juamunleo/ble_device_tfg/KiCad_PCB/BOM.xlsx

BOM
NO | Designator | Quantity | Part Number | Description | Value | Package | Comment or Link
1 | R1 | 1 |  | 200Ohms resistor | 200 | 0603
2 | R2 | 1 |  | 1kOhms resistor | 1k | 0603
3 | BT1 | 1 | BAT-HLD-001-THM-TR | Battery Holder |  |  | https://www.mouser.es/ProductDetail/Linx-Technologies/BAT-HLD-001-THM-TR?qs=1sbE9T7hb3a7mD8p42MgHg%3D%3D
4 | C2,C3,C4,C5 | 4 |  | 12pF capacitor | 12p | 0603
5 | C7, C11, C12 | 3 |  | 0.1 uF(100nF) capacitor | 0.1u | 0603
6 | C8 | 1 |  | 1uF capacitor | 1u | 0603
7 | C19 | 1 |  | 100pF capacitor | 100p | 0603
8 | C10 | 1 |  | 0.8pF capacitor | 0.8p | 0603
9 | C13 | 1 |  | 4.7uF capacitor | 4.7u | 0603
10 | D1 | 1 | 597-3111-407F | LED |  |  | https://www.mouser.es/ProductDetail/Dialight/597-3111-407F?qs=DVhSRDYZfLqO0KXLkTIRsA%3D%3D
11 | E1 | 1 | 2450AT18B100E | Bluetooth 2.45GHz Antenna |  |  | https://www.mouser.es/ProductDetail/Johanson-Technology/2450AT18B100E?qs=yCnrNFeXz%252Bh5MFsFIXGZGA%3D%3D
12 | J1 | 1 | 53048-0450 | Headers & Wire Housings |  |  | https://www.mouser.es/ProductDetail/Molex/53048-0450?qs=0lSvoLzn4L%252Bhzo05ywM78Q%3D%3D
13 | L1 | 1 | CV201210-100K | 10uH inductor | 10u |  | https://www.mouser.es/ProductDetail/Bourns/CV201210-100K?qs=k2%252BVLg4AuuRLt64STpwovw%3D%3D
14 | L2 | 1 | CE201210-3N9J | 3.9nH inductor | 3.9n |  | https://www.mouser.es/ProductDetail/Bourns/CE201210-3N9J?qs=BtXXpjEiAfEUCJPU6Gr3oA%3D%3D
15 | L3 | 1 | CE201210-15NJ | 15nH inductor | 15n |  | https://www.mouser.es/ProductDetail/Bourns/CE201210-15NJ?qs=8tpky8Qe03JgTaGyIOKDlQ%3D%3D
16 | S1 | 1 | FSMCTTR | Switch |  |  | https://www.mouser.es/ProductDetail/TE-Connectivity-Alcoswitch/FSMCTTR?qs=Of7OaoM7rsGuzG65URnwLw%3D%3D
17 | U2 | 1 | nRF52832-QFAA-R | nrf52832 SoC |  |  | https://www.mouser.es/ProductDetail/Nordic-Semiconductor/nRF52832-QFAA-R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
18 | Y1 | 1 | ECS-320-8-33B-7KM-TR | Crystals 32MHz 8pF 40 ohms -20C to 70C | 32MHz |  | https://www.mouser.es/ProductDetail/ECS/ECS-320-8-33B-7KM-TR?qs=B6kkDfuK7%2FCuFLoe%2FuNdsQ%3D%3D
19 | Y2 | 1 | ECS-.327-12.5-12R-TR | Crystals 32.768kHz 12.5pF -40C +85C | 32.768KHz |  | https://www.mouser.es/ProductDetail/ECS/ECS-327-125-12R-TR?qs=fAHHVMwC%252BbjIsh0rr7Av6w%3D%3D
