juamunleo/ble_device_tfg/KiCad_PCB/simbolos_huellas_externos/2450AT18B100E/2450AT18B100E.step

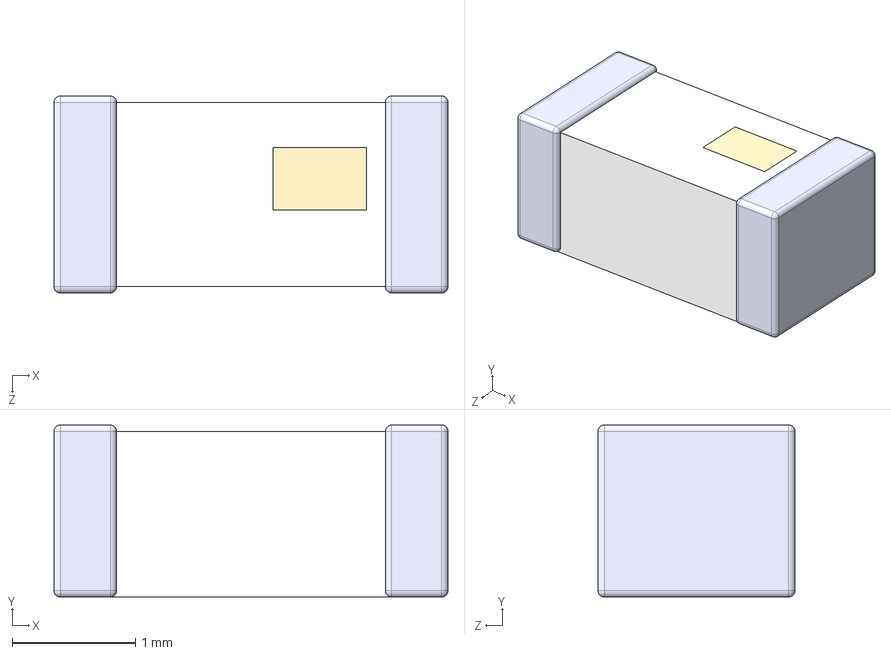
[picture p1: CAD file, 2022-02-11]
KiCad_PCB/simbolos_huellas_externos/2450AT18B100E/2450AT18B100E.step
3.20 x 1.40 x 1.60 mm
