juamunleo/ble_device_tfg/KiCad_PCB/simbolos_huellas_externos/597-3111-407F/597-3111-407F.step

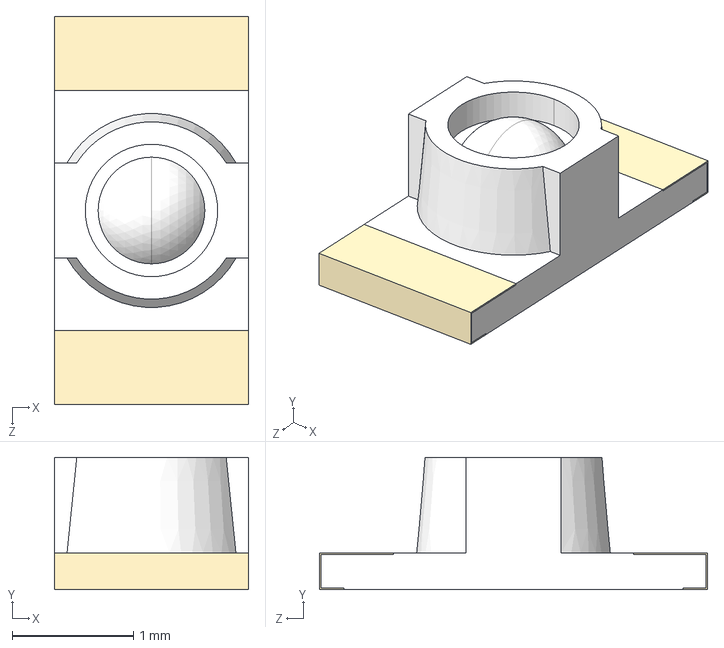
[picture p2: CAD file, 2022-02-11]
KiCad_PCB/simbolos_huellas_externos/597-3111-407F/597-3111-407F.step
1.60 x 1.09 x 3.20 mm
