juamunleo/ble_device_tfg/KiCad_PCB/simbolos_huellas_externos/8-1437565-0/8-1437565-0.step

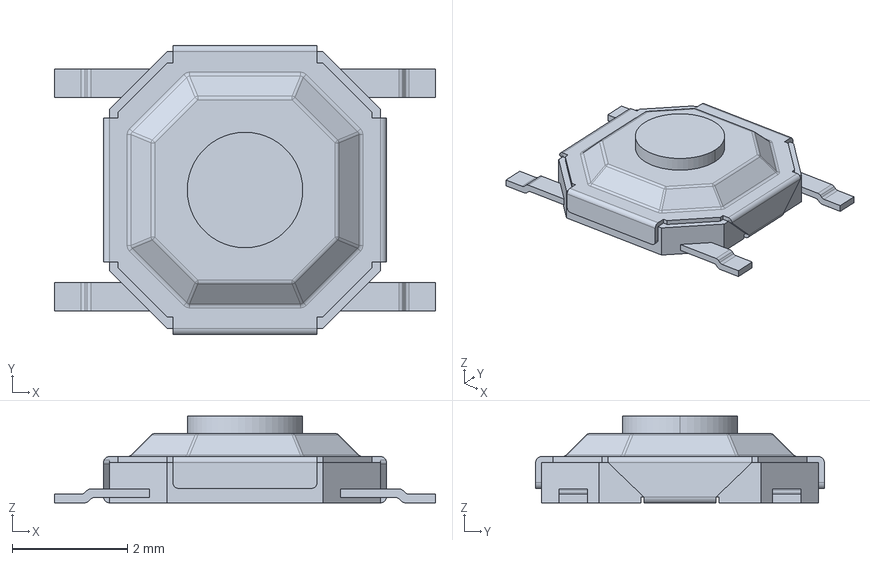
[picture p3: CAD file, 2022-02-11]
KiCad_PCB/simbolos_huellas_externos/8-1437565-0/8-1437565-0.step
6.60 x 5.00 x 1.50 mm
