juamunleo/ble_device_tfg/KiCad_PCB/simbolos_huellas_externos/B3U-3000P/B3U-3000P.step

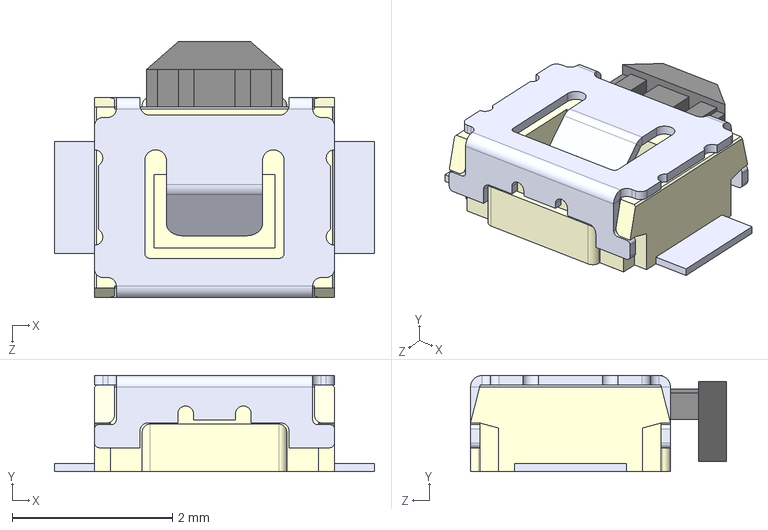
[picture p4: CAD file, 2022-02-11]
KiCad_PCB/simbolos_huellas_externos/B3U-3000P/B3U-3000P.step
4.00 x 1.20 x 3.20 mm
