juamunleo/ble_device_tfg/KiCad_PCB/simbolos_huellas_externos/BAT-HLD-001-THM-TR/BAT-HLD-001-THM-TR.step

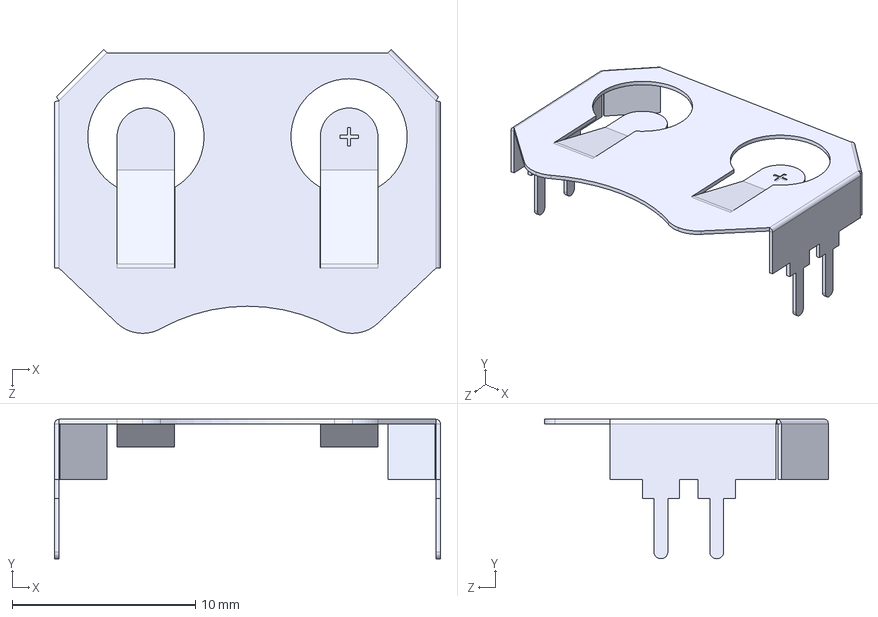
[picture p5: CAD file, 2022-03-05]
KiCad_PCB/simbolos_huellas_externos/BAT-HLD-001-THM-TR/BAT-HLD-001-THM-TR.step
21.1 x 7.62 x 15.5 mm
