juamunleo/ble_device_tfg/KiCad_PCB/simbolos_huellas_externos/ECS-.327-12.5-12R-TR/ECS-.327-12.5-12R-TR.step

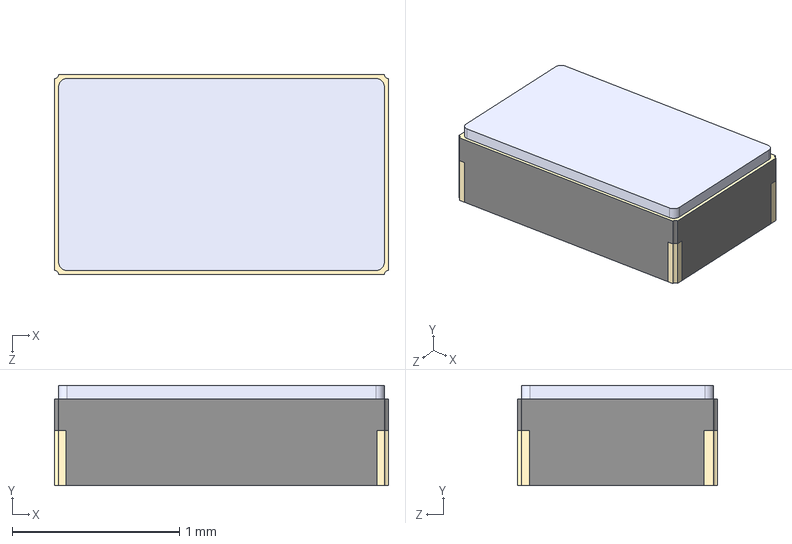
[picture p6: CAD file, 2022-02-11]
KiCad_PCB/simbolos_huellas_externos/ECS-.327-12.5-12R-TR/ECS-.327-12.5-12R-TR.step
2.00 x 0.6 x 1.20 mm
