juamunleo/ble_device_tfg/KiCad_PCB/simbolos_huellas_externos/LT3021ES8/LT3021ES8.step

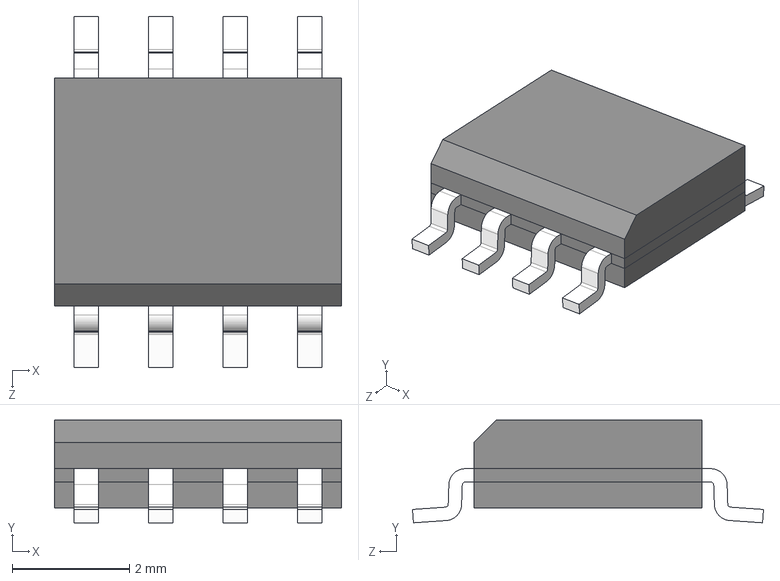
[picture p7: CAD file, 2022-02-10]
KiCad_PCB/simbolos_huellas_externos/LT3021ES8/LT3021ES8.step
4.90 x 1.75 x 5.99 mm
