juamunleo/ble_device_tfg/KiCad_PCB/simbolos_huellas_externos/USB-C31-S-RA-CS2-SMT-BK-T R/USB-C31-S-RA-CS2-SMT-BK-T_R.step

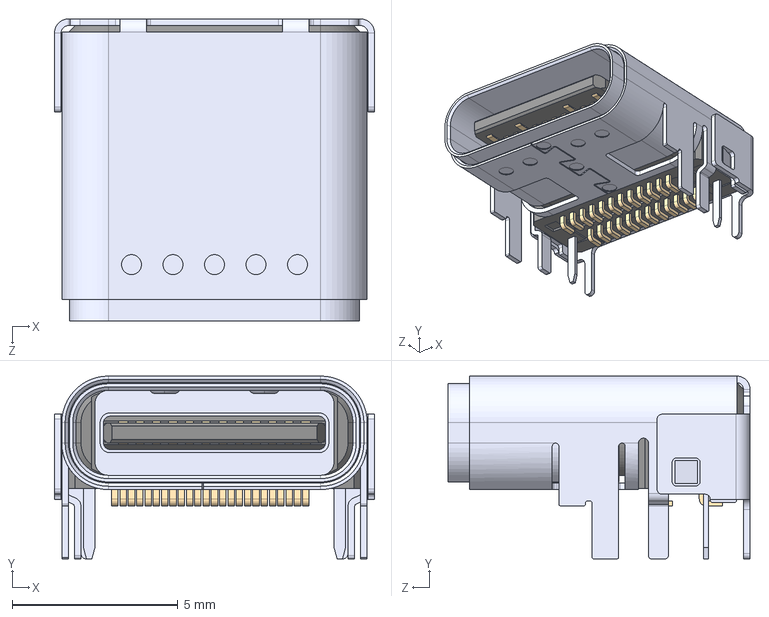
[picture p8: CAD file, 2022-02-10]
KiCad_PCB/simbolos_huellas_externos/USB-C31-S-RA-CS2-SMT-BK-T R/USB-C31-S-RA-CS2-SMT-BK-T_R.step
9.64 x 5.51 x 9.10 mm
