juamunleo/ble_device_tfg/KiCad_PCB/simbolos_huellas_externos/530480450/530480450.stp

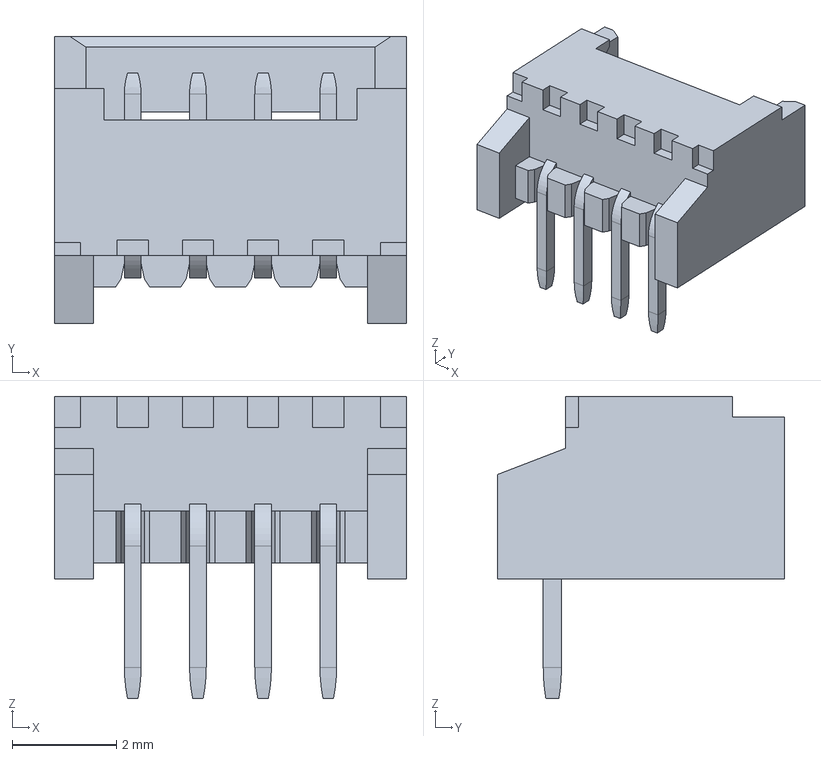
[picture p9: CAD file, 2022-03-05]
KiCad_PCB/simbolos_huellas_externos/530480450/530480450.stp
6.75 x 5.50 x 5.80 mm
