juamunleo/ble_device_tfg/KiCad_PCB/simbolos_huellas_externos/NRF52832-QFAA-R/NRF52832-QFAA-R.step

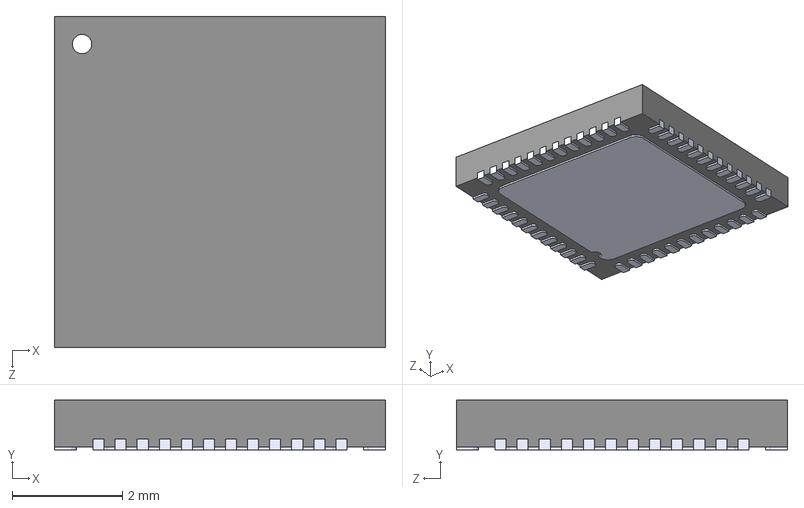
[picture p10: CAD file, 2022-02-10]
KiCad_PCB/simbolos_huellas_externos/NRF52832-QFAA-R/NRF52832-QFAA-R.step
6.00 x 0.9 x 6.00 mm
