juamunleo/ble_device_tfg/KiCad_PCB/KiCad_PCB.kicad_pcb

## KiCad design KiCad_PCB/KiCad_PCB.kicad_pcb (2022-03-21)

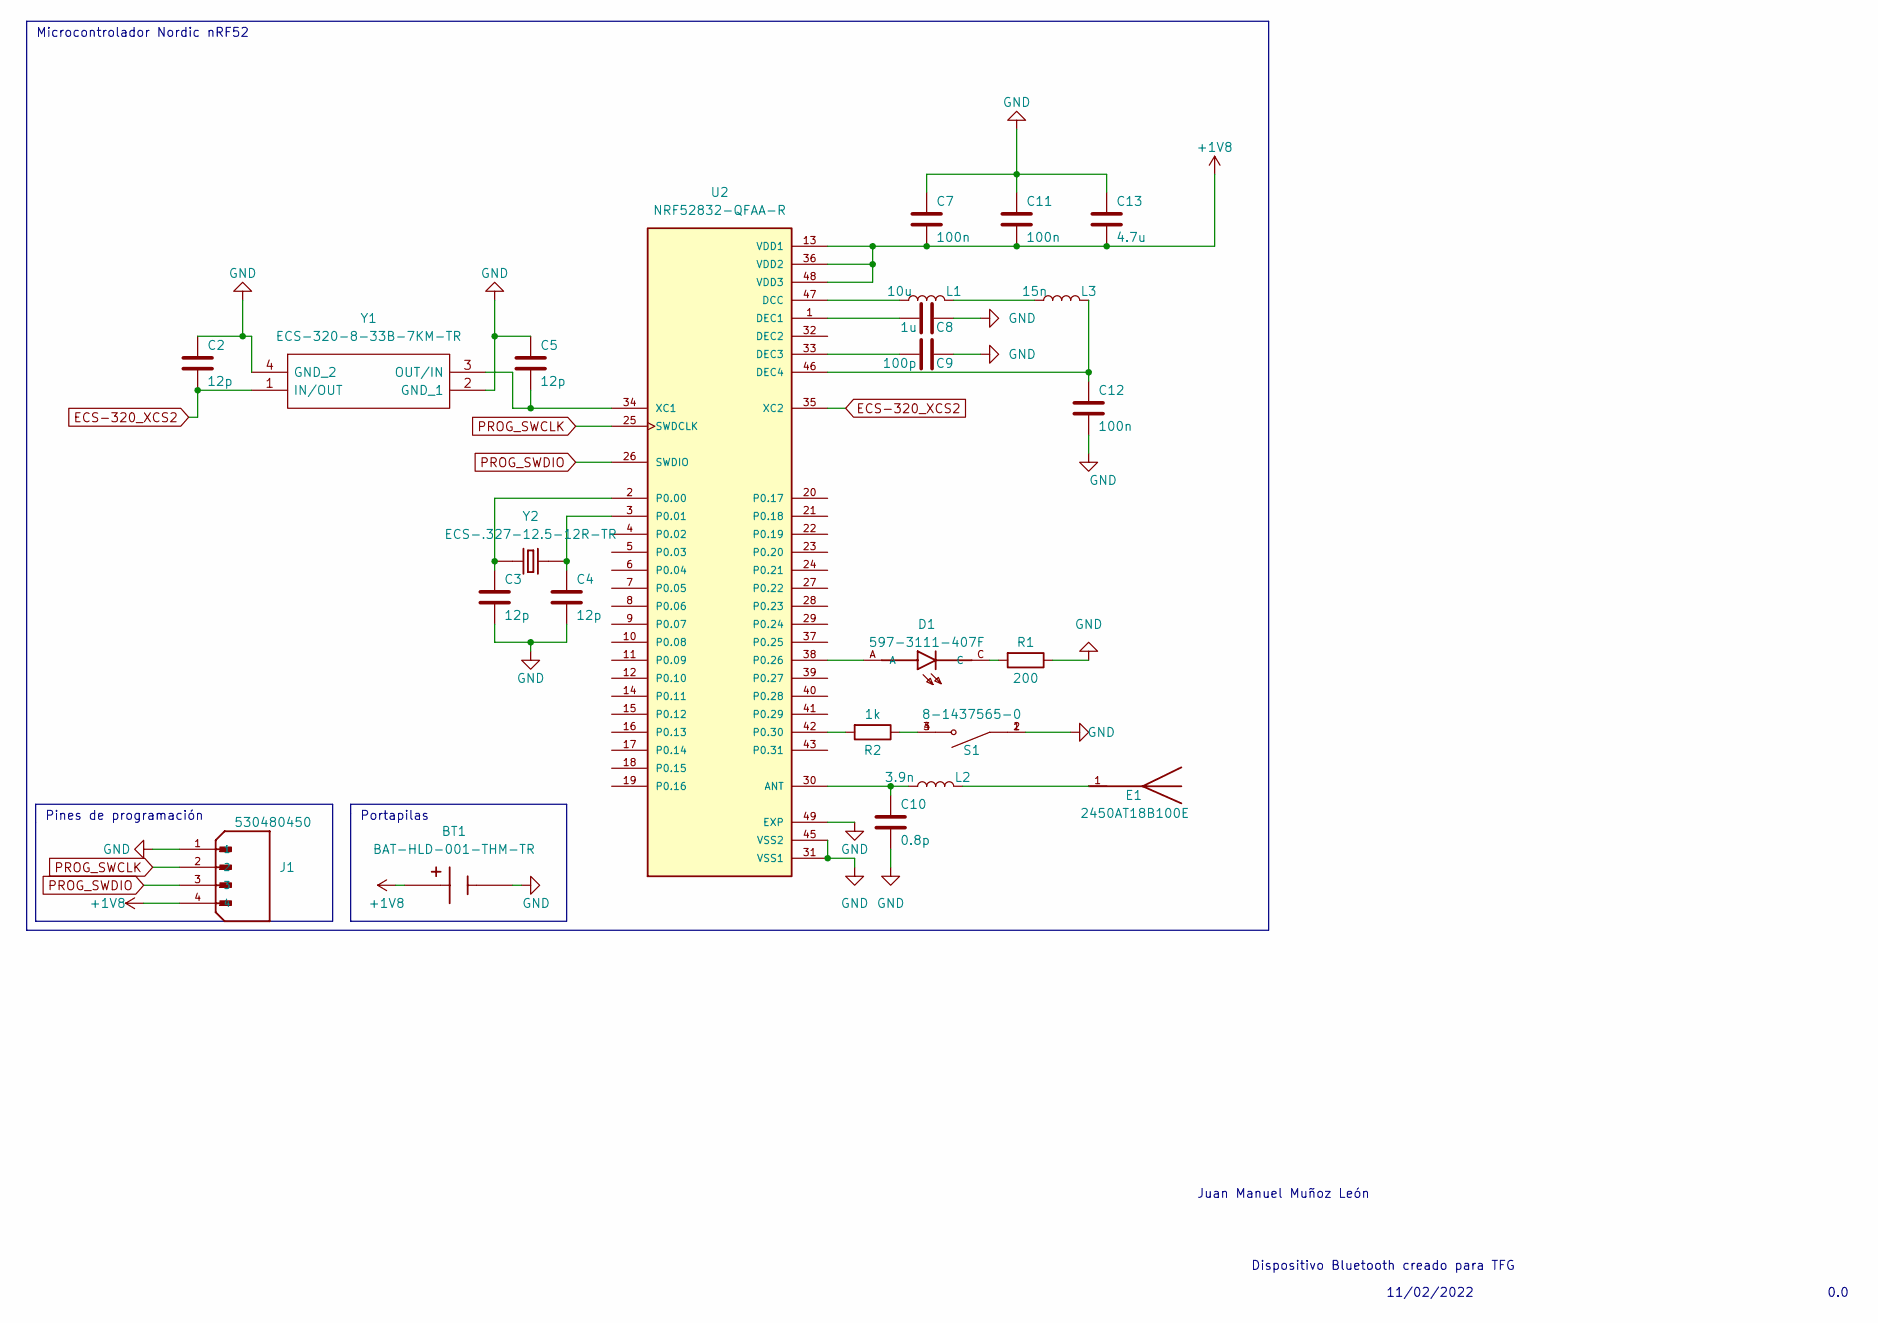
[picture p11: schematic KiCad_PCB.kicad_sch]

Parts:
BT1: BAT-HLD-001-THM-TR; BAT_BAT-HLD-001-THM-TR; PARTREV C
C2, C3, C4, C5: 12p; C_0603_1608Metric
C7, C11, C12: 100n; C_0603_1608Metric
C8: 1u; C_0603_1608Metric
C9: 100p; C_0603_1608Metric
C10: 0.8p; C_0603_1608Metric
C13: 4.7u; C_0603_1608Metric
D1: 597-3111-407F; LEDC3216X110N
E1: 2450AT18B100E; XDCR_2450AT18B100E; PARTREV 4.0
J1: 530480450; MOLEX_530480450; PARTREV A
L1: 10u; L_0805_2012Metric
L2: 3.9n; L_0805_2012Metric
L3: 15n; L_0805_2012Metric
R1: 200; R_0603_1608Metric
R2: 1k; R_0603_1608Metric
S1: 8-1437565-0; SW_8-1437565-0
U2: NRF52832-QFAA-R; QFN40P600X600X90-49N
Y1: ECS-320-8-33B-7KM-TR; ECS320833B7KMTR; Manufacturer_Part_Number ECS-320-8-33B-7KM-TR; Mouser Part Number 520-320-8-33B-7KM-TR
Y2: ECS-.327-12.5-12R-TR; XTAL_ECS-.327-12.5-12R-TR; PARTREV 2017

Connections:
+1V8: BT1.P1, BT1.P2, BT1.P3, BT1.P4, C7.2, C11.2, C13.2, J1.4, U2.13 (VDD1), U2.36 (VDD2), U2.48 (VDD3)
ECS-320_XCS2: C2.2, U2.35 (XC2), Y1.1 (IN/OUT)
GND: BT1.N, C2.1, C3.2, C4.2, C5.1, C7.1, C8.1, C9.1, C10.2, C11.1, C12.2, C13.1, J1.1, R1.1, S1.1, S1.2, U2.31 (VSS1), U2.45 (VSS2), U2.49 (EXP), Y1.2 (GND_1), Y1.4 (GND_2)
unnamed: C3.1, U2.2 (P0.00), Y2.1
unnamed: C4.1, U2.3 (P0.01), Y2.2
unnamed: C5.2, U2.34 (XC1), Y1.3 (OUT/IN)
unnamed: C8.2, U2.1 (DEC1)
unnamed: C9.2, U2.33 (DEC3)
unnamed: C10.1, L2.1, U2.30 (ANT)
unnamed: C12.1, L3.2, U2.46 (DEC4)
unnamed: D1.A, U2.38 (P0.26)
unnamed: D1.C, R1.2
unnamed: E1.1, L2.2
unnamed: L1.1, U2.47 (DCC)
unnamed: L1.2, L3.1
unnamed: R2.1, S1.3, S1.4
unnamed: R2.2, U2.42 (P0.30)
PROG_SWCLK: J1.2, U2.25 (SWDCLK)
PROG_SWDIO: J1.3, U2.26 (SWDIO)

Notes on the sheet:
Pines de programación
Juan Manuel Muñoz León
Microcontrolador Nordic nRF52
Dispositivo Bluetooth creado para TFG
Portapilas
11/02/2022
0.0

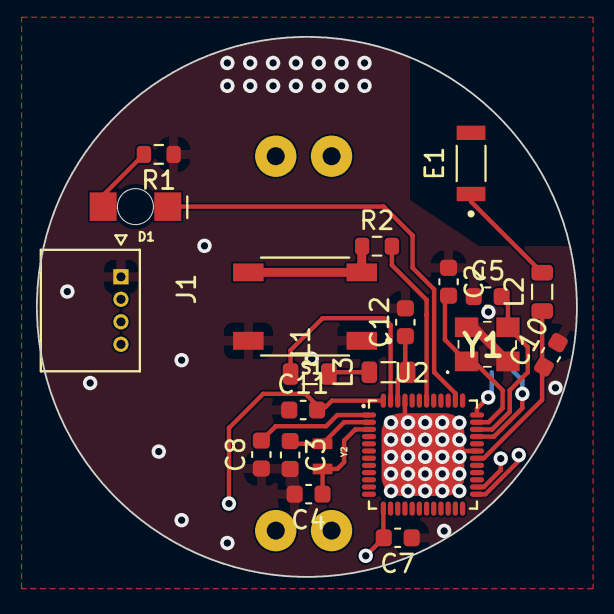
[picture p12: board KiCad_PCB.kicad_pcb from above]

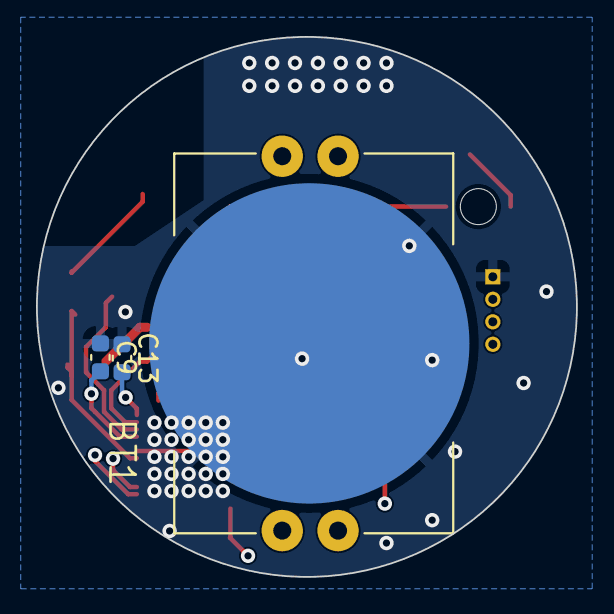
[picture p13: board KiCad_PCB.kicad_pcb from below]

Board: 4 copper layers, 30.0 x 30.0 mm, 24 parts (3 on the bottom side), 19 nets.
