juamunleo/ble_device_tfg/(commit log)

2022-02-10 KiCad project creation
    [KiCad_PCB.kicad_pcb, KiCad_PCB.kicad_sch]
2022-02-10 Adding footprints and symbols to KiCad project
    [LT3021ES8.step, NRF52832-QFAA-R.step, USB-C31-S-RA-CS2-SMT-BK-T_R.step]
2022-02-11 KiCad schematic done
    [2450AT18B100E.step, 597-3111-407F.step, 8-1437565-0.step, B3U-3000P.step, ECS-.327-12.5-12R-TR.step, KiCad_PCB.kicad_sch]
2022-02-15 PCB in progress
    [KiCad_PCB.kicad_pcb, KiCad_PCB.kicad_sch]
2022-02-22 Updated KiCad project
    [KiCad_PCB-B_Cu.gbr, KiCad_PCB-B_Mask.gbr, KiCad_PCB-B_Paste.gbr, KiCad_PCB-B_Silkscreen.gbr, KiCad_PCB-Edge_Cuts.gbr, KiCad_PCB-F_Cu.gbr, KiCad_PCB-F_Mask.gbr, KiCad_PCB-F_Paste.gbr]
2022-03-05 Updated footprints and added battery holder on KiCad project
    [530480450.stp, BAT-HLD-001-THM-TR.step, KiCad_PCB.kicad_pcb, KiCad_PCB.kicad_sch]
2022-03-10 Added BOM template file
    [BOM-template.xlsx]
2022-03-10 Tutorías 10/3
    [KiCad_PCB.kicad_pcb, KiCad_PCB.kicad_sch]
2022-03-14 PCB size reduced
    [KiCad_PCB.kicad_pcb]
2022-03-16 Rewrited wrong part numbers and added links to the BOM file
    [BOM-template.xlsx, BOM.xlsx]
2022-03-17 Tutoría Modificacion PCB
    [BOM.xlsx, KiCad_PCB.kicad_pcb, KiCad_PCB.kicad_sch]
2022-03-21 GBR Files generated
    [KiCad_PCB-B_Cu.gbr, KiCad_PCB-B_Mask.gbr, KiCad_PCB-B_Paste.gbr, KiCad_PCB-B_Silkscreen.gbr, KiCad_PCB-Edge_Cuts.gbr, KiCad_PCB-F_Cu.gbr, KiCad_PCB-F_Mask.gbr, KiCad_PCB-F_Paste.gbr]
2022-07-10 Reworked android app. Added python post server + telegram bot. Fixed connections in segger project.
    [PostBuilder.java, main.c, sdk_config.h]
2022-08-01 Removed LED characteristic from Bluetooth. Now LED blinks with a timer every 500ms.
2022-08-03 Added support for battery
